Nyokiyasu/RemoteHand-controller/Solid/コントローラ(ジョイスティック).SLDASM

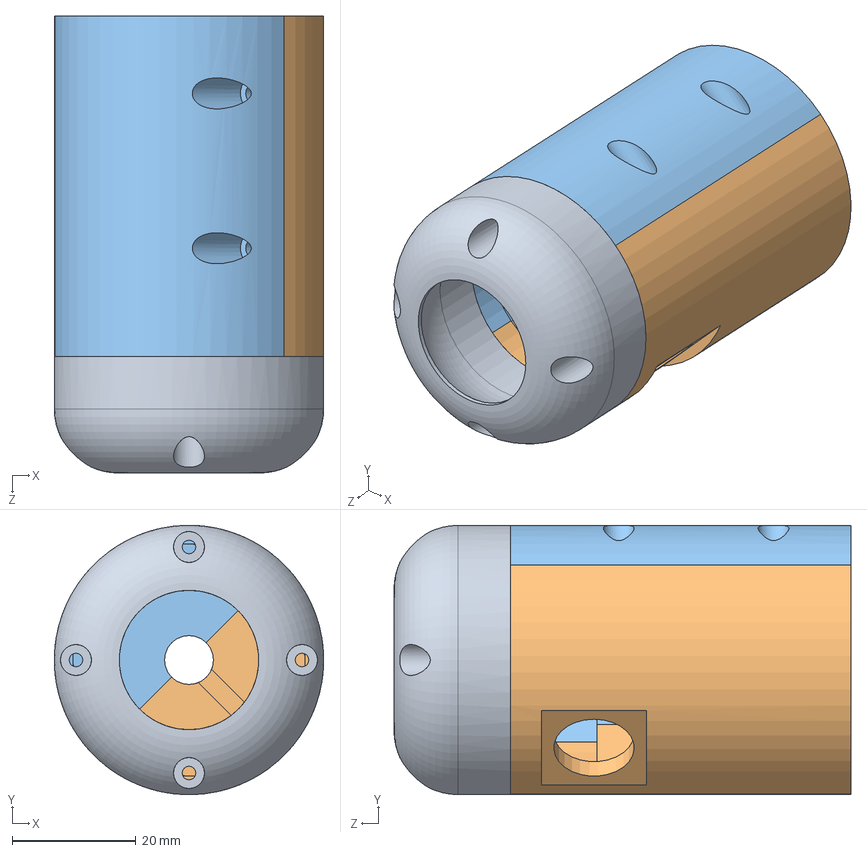
[picture p1: CAD file, 2017-09-04]
Solid/コントローラ(ジョイスティック).SLDASM
43.5 x 43.5 x 73.8 mm
ジョイスティックのカバー
ジョイスティック持つところ_halfbody
ジョイスティック持つところ_halfhead
