Nyokiyasu/RemoteHand-controller/Solid/ジョイスティック持つところ_halfbody.SLDPRT

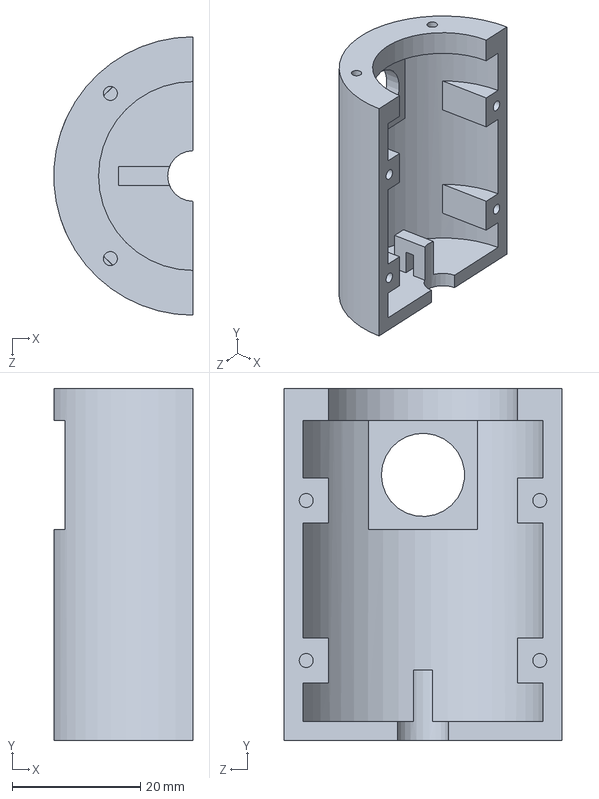
[picture p2: CAD file, 2017-09-04]
Solid/ジョイスティック持つところ_halfbody.SLDPRT
21.7 x 55.0 x 43.5 mm
