Nyokiyasu/RemoteHand-controller/Solid/ジョイスティック持つところ_halfhead.SLDPRT

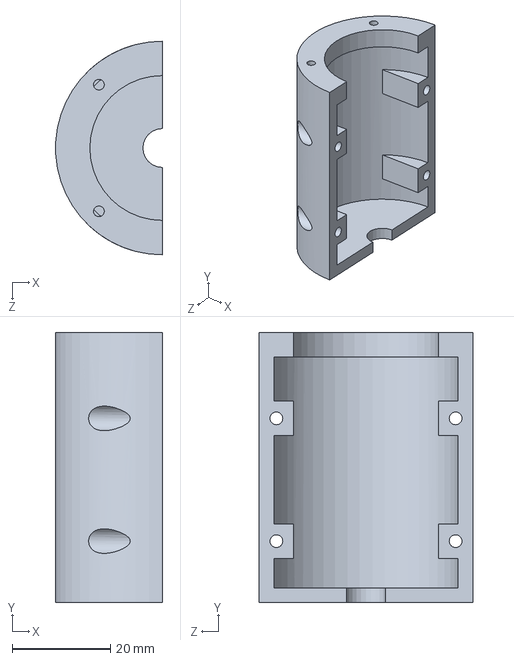
[picture p3: CAD file, 2017-09-04]
Solid/ジョイスティック持つところ_halfhead.SLDPRT
21.7 x 55.0 x 43.5 mm
