Nyokiyasu/RemoteHand-controller/Solid/ジョイスティック持つところ.SLDPRT

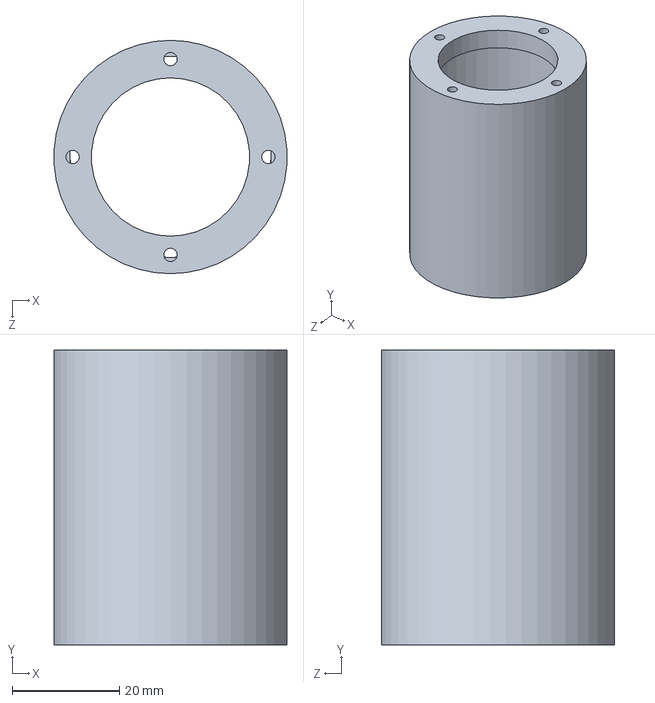
[picture p4: CAD file, 2017-08-24]
Solid/ジョイスティック持つところ.SLDPRT
43.4 x 55.0 x 43.5 mm
