Nyokiyasu/RemoteHand-controller/Solid/ジョイスティックのカバー.SLDPRT

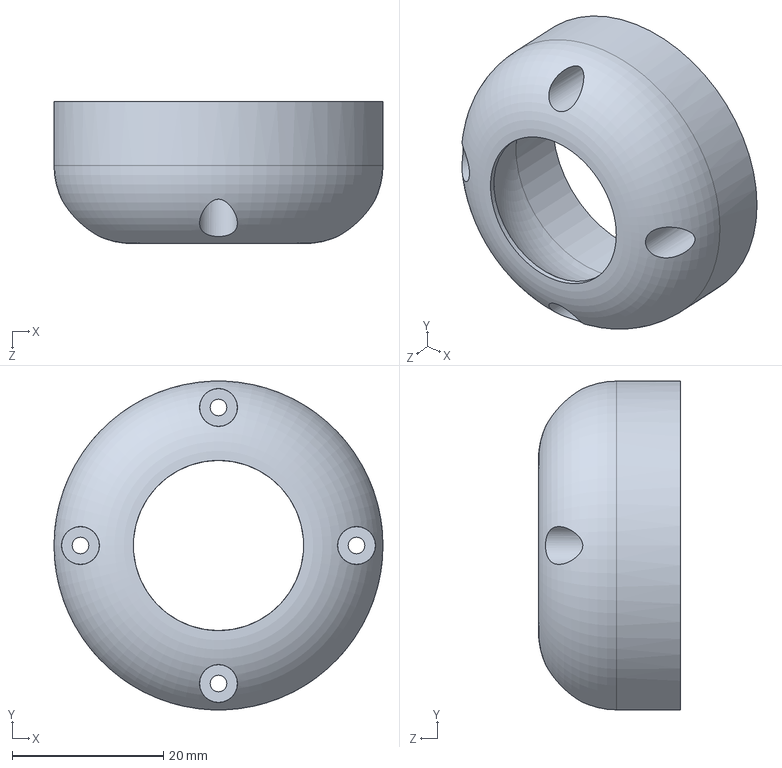
[picture p5: CAD file, 2017-08-24]
Solid/ジョイスティックのカバー.SLDPRT
43.5 x 43.5 x 18.8 mm
