Nyokiyasu/RemoteHand-controller/Solid/ジョイスティック.SLDPRT

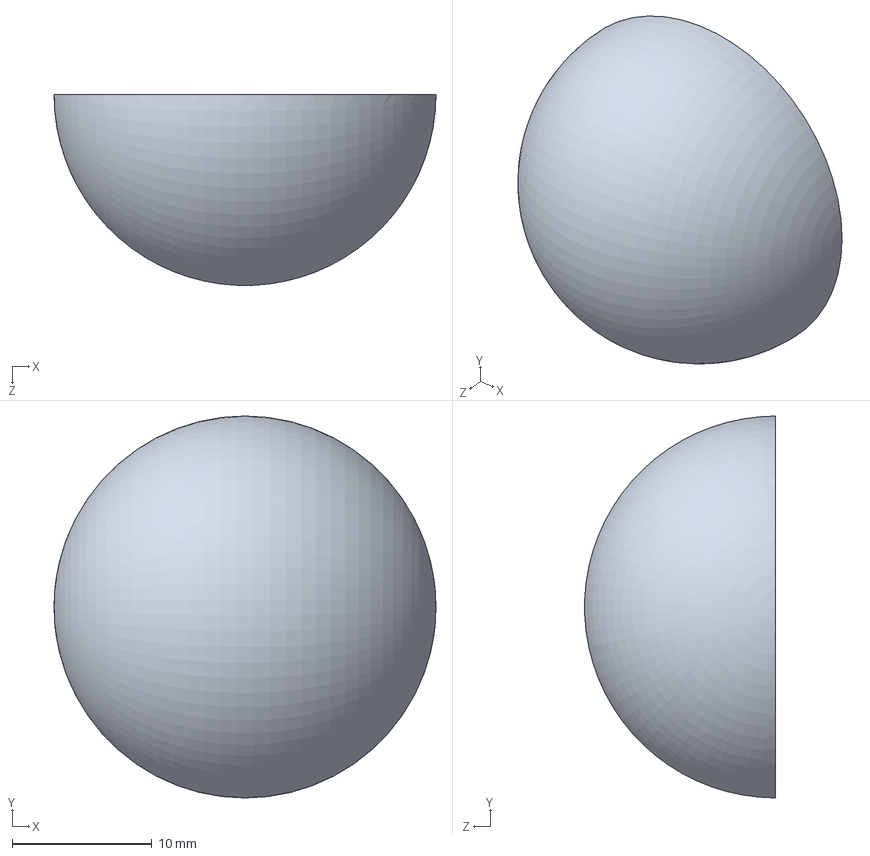
[picture p6: CAD file, 2017-08-09]
Solid/ジョイスティック.SLDPRT
27.3 x 27.3 x 13.6 mm
