Nyokiyasu/RemoteHand-controller/Solid/ジョイスティック固定SLDPRT.SLDPRT

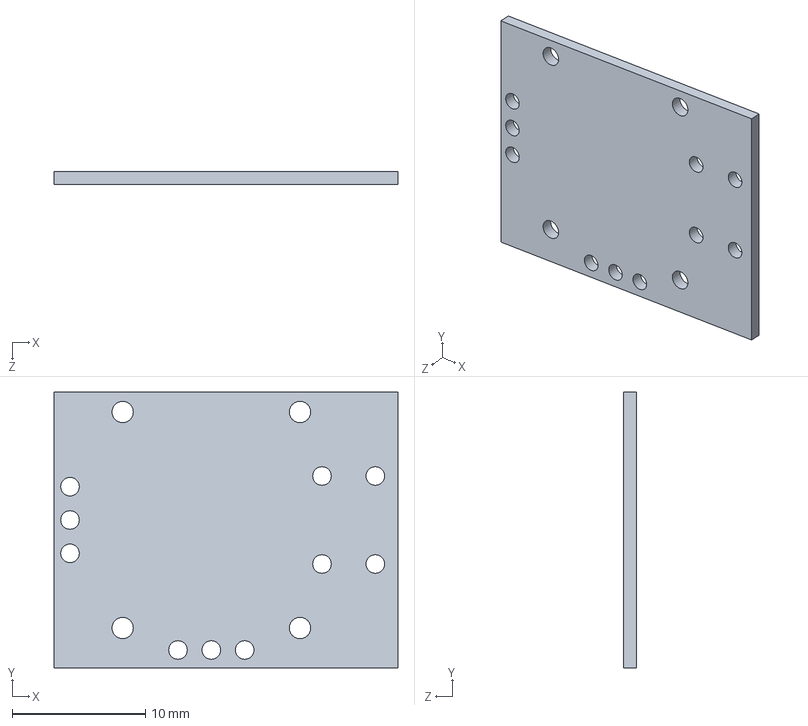
[picture p7: CAD file, 2017-08-08]
Solid/ジョイスティック固定SLDPRT.SLDPRT
25.8 x 20.7 x 1.00 mm
