Nyokiyasu/RemoteHand-controller/Circuit/MainControl/V2/rhand_controller.kicad_pcb

## KiCad design Circuit/MainControl/V2/rhand_controller.kicad_pcb (2017-09-01)

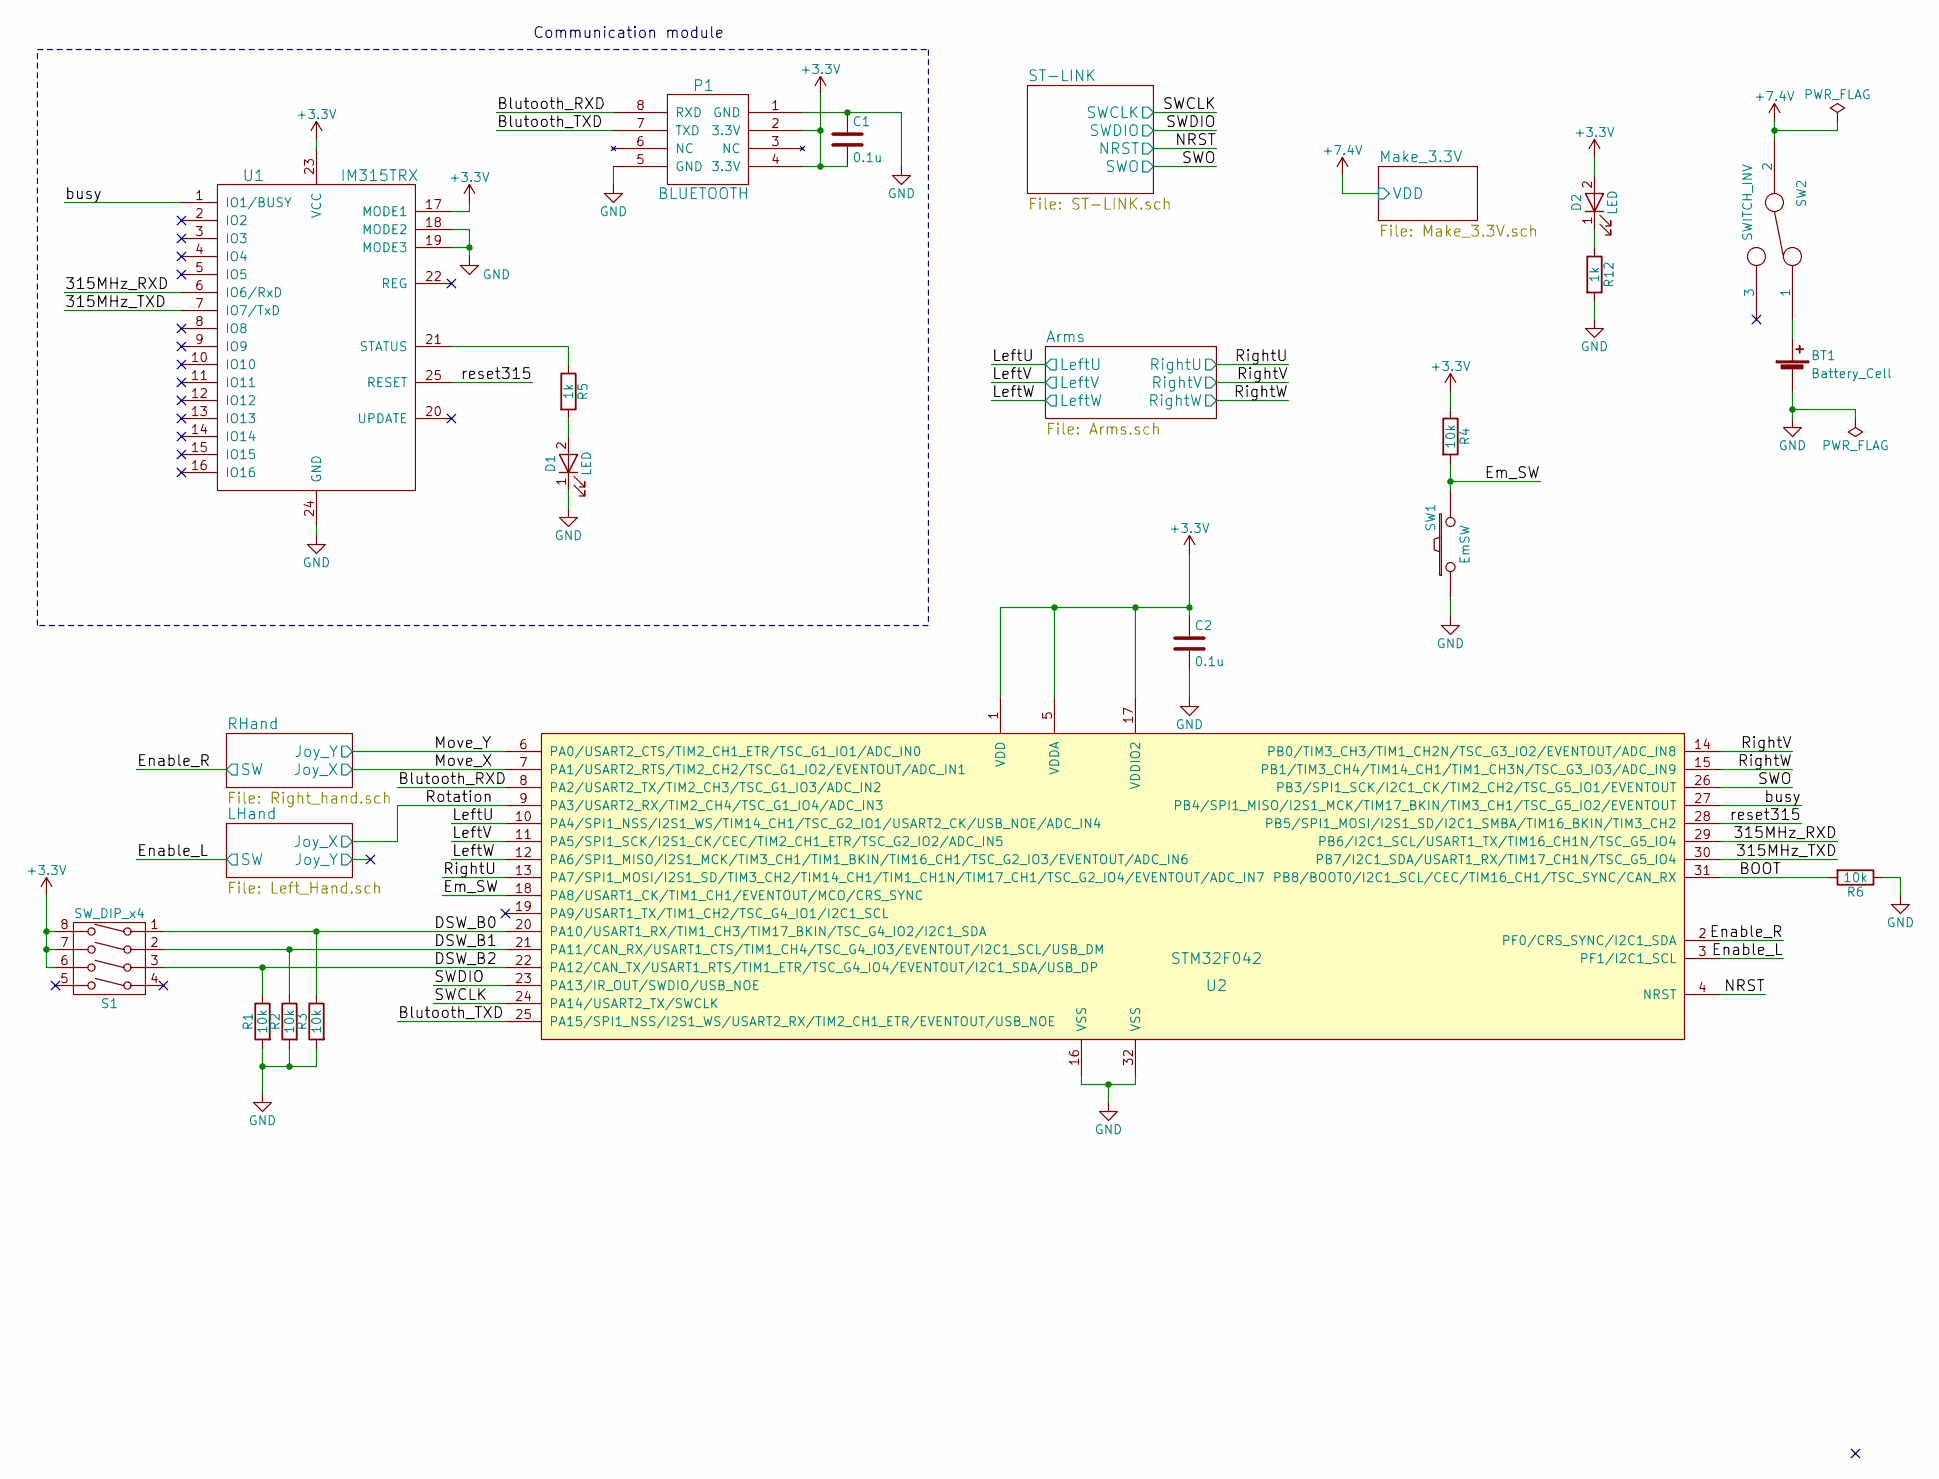
[picture p8: schematic rhand_controller.sch]

Parts:
BT1: Battery_Cell; XT_Mdot
C1, C2: 0.1u; C_0805_HandSoldering_LP
D1, D2: LED; LED_D5.0mm
P1: BLUETOOTH; ESD200
R1, R2, R3, R6: 10k; R_0603_HandSoldering_LP
R4: 10k; R_Axial_DIN0207_L6.3mm_D2.5mm_P7.62mm_Horizontal
R5, R12: 1k; R_Axial_DIN0207_L6.3mm_D2.5mm_P7.62mm_Horizontal
S1: SW_DIP_x4; SW_DIP_x4_W7.62mm_Slide
SW1: EmSW; XA_2Pin_LP
SW2: SWITCH_INV; _SW_TGR
U1: IM315TRX; IM315
U2: STM32F042; LQFP-32_7x7mm_Pitch0.8mm

Connections:
+3V3: C1.2, C2.1, D2.2 (A), P1.2 (3.3V), P1.4 (3.3V), R4.1, S1.6, S1.7, S1.8, U1.17 (MODE1), U1.23 (VCC), U2.1 (VDD), U2.5 (VDDA), U2.17 (VDDIO2); also elsewhere on the board
+7.4V: SW2.2; also elsewhere on the board
/315MHz_RXD: U1.6 (IO6/RxD), U2.29 (PB6/I2C1_SCL/USART1_TX/TIM16_CH1N/TSC_G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)
/315MHz_TXD: U1.7 (IO7/TxD), U2.30 (PB7/I2C1_SDA/USART1_RX/TIM17_CH1N/TSC_G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)
/BOOT: R6.2, U2.31 (PB8/BOOT0/I2C1_SCL/CEC/TIM16_CH1/TSC_SY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)
/Blutooth_RXD: P1.8 (RXD), U2.8 (PA2/USART2_TX/TIM2_CH3/TSC_G1_IO3/ADC_I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)
/Blutooth_TXD: P1.7 (TXD), U2.25 (PA15/SPI1_NSS/I2S1_WS/USART2_RX/TIM2_CH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)
/DSW_B0: R3.1, S1.1, U2.20 (PA10/USART1_RX/TIM1_CH3/TIM17_BKIN/TSC_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)
/DSW_B1: R2.1, S1.2, U2.21 (PA11/CAN_RX/USART1_CTS/TIM1_CH4/TSC_G4_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)
/DSW_B2: R1.1, S1.3, U2.22 (PA12/CAN_TX/USART1_RTS/TIM1_ETR/TSC_G4_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)
/Em_SW: R4.2, SW1.2, U2.18 (PA8/USART1_CK/TIM1_CH1/EVENTOUT/MCO/CRS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)
/Enable_L: U2.3 (PF1/I2C1_SCL); also elsewhere on the board
/Enable_R: U2.2 (PF0/CRS_SYNC/I2C1_SDA); also elsewhere on the board
/LeftU: U2.10 (PA4/SPI1_NSS/I2S1_WS/TIM14_CH1/TSC_G2_I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); also elsewhere on the board
/LeftV: U2.11 (PA5/SPI1_SCK/I2S1_CK/CEC/TIM2_CH1_ETR/T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); also elsewhere on the board
/LeftW: U2.12 (PA6/SPI1_MISO/I2S1_MCK/TIM3_CH1/TIM1_BK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); also elsewhere on the board
/Move_X: U2.7 (PA1/USART2_RTS/TIM2_CH2/TSC_G1_IO2/EVEN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); also elsewhere on the board
/Move_Y: U2.6 (PA0/USART2_CTS/TIM2_CH1_ETR/TSC_G1_IO1/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); also elsewhere on the board
/NRST: U2.4 (NRST); also elsewhere on the board
/RightU: U2.13 (PA7/SPI1_MOSI/I2S1_SD/TIM3_CH2/TIM14_CH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); also elsewhere on the board
/RightV: U2.14 (PB0/TIM3_CH3/TIM1_CH2N/TSC_G3_IO2/EVENT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); also elsewhere on the board
/RightW: U2.15 (PB1/TIM3_CH4/TIM14_CH1/TIM1_CH3N/TSC_G3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); also elsewhere on the board
/Rotation: U2.9 (PA3/USART2_RX/TIM2_CH4/TSC_G1_IO4/ADC_I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); also elsewhere on the board
/SWCLK: U2.24 (PA14/USART2_TX/SWCLK); also elsewhere on the board
/SWDIO: U2.23 (PA13/IR_OUT/SWDIO/USB_NOE); also elsewhere on the board
/SWO: U2.26 (PB3/SPI1_SCK/I2C1_CK/TIM2_CH2/TSC_G5_IO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); also elsewhere on the board
/busy: U1.1 (IO1/BUSY), U2.27 (PB4/SPI1_MISO/I2S1_MCK/TIM17_BKIN/TIM3_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)
/reset315: U1.25 (RESET), U2.28 (PB5/SPI1_MOSI/I2S1_SD/I2C1_SMBA/TIM16_B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)
GND: BT1.2 (-), C1.1, C2.2, D1.1 (K), P1.1 (GND), P1.5 (GND), R1.2, R2.2, R3.2, R6.1, R12.2, SW1.1, U1.18 (MODE2), U1.19 (MODE3), U1.24 (GND), U2.16 (VSS), U2.32 (VSS); also elsewhere on the board
unnamed: BT1.1 (+), SW2.1
unnamed: D1.2 (A), R5.2
unnamed: D2.1 (K), R12.1
unnamed: R5.1, U1.21 (STATUS)

Notes on the sheet:
Communication module

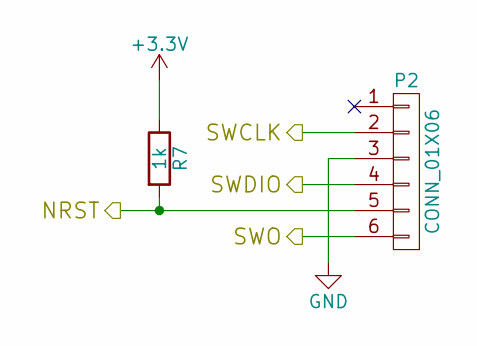
[picture p9: schematic ST-LINK.sch]

Parts:
P2: CONN_01X06; Pin_Header_Straight_1x06_Pitch2.54mm
R7: 1k; R_Axial_DIN0207_L6.3mm_D2.5mm_P7.62mm_Horizontal

Connections:
+3V3: R7.1; also elsewhere on the board
/NRST: P2.5, R7.2; also elsewhere on the board
/SWCLK: P2.2; also elsewhere on the board
/SWDIO: P2.4; also elsewhere on the board
/SWO: P2.6; also elsewhere on the board
GND: P2.3; also elsewhere on the board

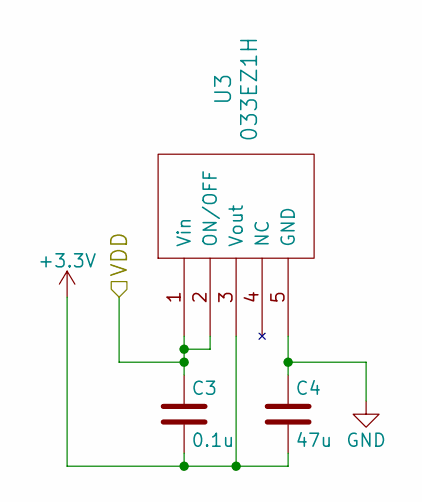
[picture p10: schematic Make_3.3V.sch]

Parts:
C3: 0.1u; C_0805_HandSoldering_LP
C4: 47u; C_1210_HandSoldering_LP
U3: 033EZ1H; PQ033EZ1HZ

Connections:
+3V3: C3.2, C4.2, U3.3 (Vout); also elsewhere on the board
+7.4V: C3.1, U3.1 (Vin), U3.2 (ON/OFF); also elsewhere on the board
GND: C4.1, U3.5 (GND); also elsewhere on the board

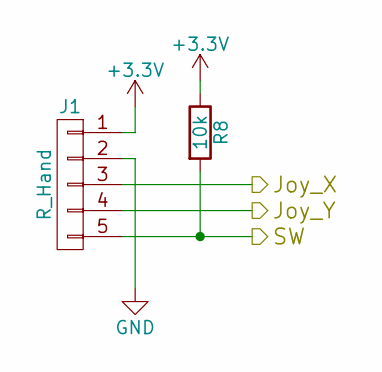
[picture p11: schematic Right_hand.sch]

Parts:
J1: R_Hand; XA_5Pin_LP
R8: 10k; R_Axial_DIN0207_L6.3mm_D2.5mm_P7.62mm_Horizontal

Connections:
+3V3: J1.1, R8.1; also elsewhere on the board
/Enable_R: J1.5, R8.2; also elsewhere on the board
/Move_X: J1.3; also elsewhere on the board
/Move_Y: J1.4; also elsewhere on the board
GND: J1.2; also elsewhere on the board

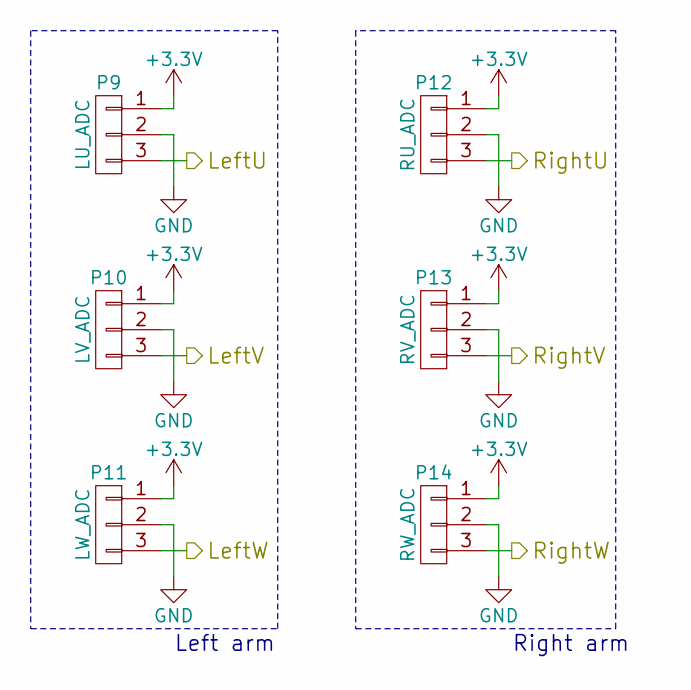
[picture p12: schematic Arms.sch]

Parts:
P9: LU_ADC; XA_3Pin_LP
P10: LV_ADC; XA_3Pin_LP
P11: LW_ADC; XA_3Pin_LP
P12: RU_ADC; XA_3Pin_LP
P13: RV_ADC; XA_3Pin_LP
P14: RW_ADC; XA_3Pin_LP

Connections:
+3V3: P9.1, P10.1, P11.1, P12.1, P13.1, P14.1; also elsewhere on the board
/LeftU: P9.3; also elsewhere on the board
/LeftV: P10.3; also elsewhere on the board
/LeftW: P11.3; also elsewhere on the board
/RightU: P12.3; also elsewhere on the board
/RightV: P13.3; also elsewhere on the board
/RightW: P14.3; also elsewhere on the board
GND: P9.2, P10.2, P11.2, P12.2, P13.2, P14.2; also elsewhere on the board

Notes on the sheet:
Right arm
Left arm

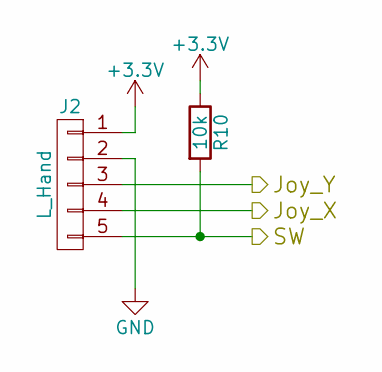
[picture p13: schematic Left_Hand.sch]

Parts:
J2: L_Hand; XA_5Pin_LP
R10: 10k; R_Axial_DIN0207_L6.3mm_D2.5mm_P7.62mm_Horizontal

Connections:
+3V3: J2.1, R10.1; also elsewhere on the board
/Enable_L: J2.5, R10.2; also elsewhere on the board
/LHand/Joy_Y: J2.3
/Rotation: J2.4; also elsewhere on the board
GND: J2.2; also elsewhere on the board

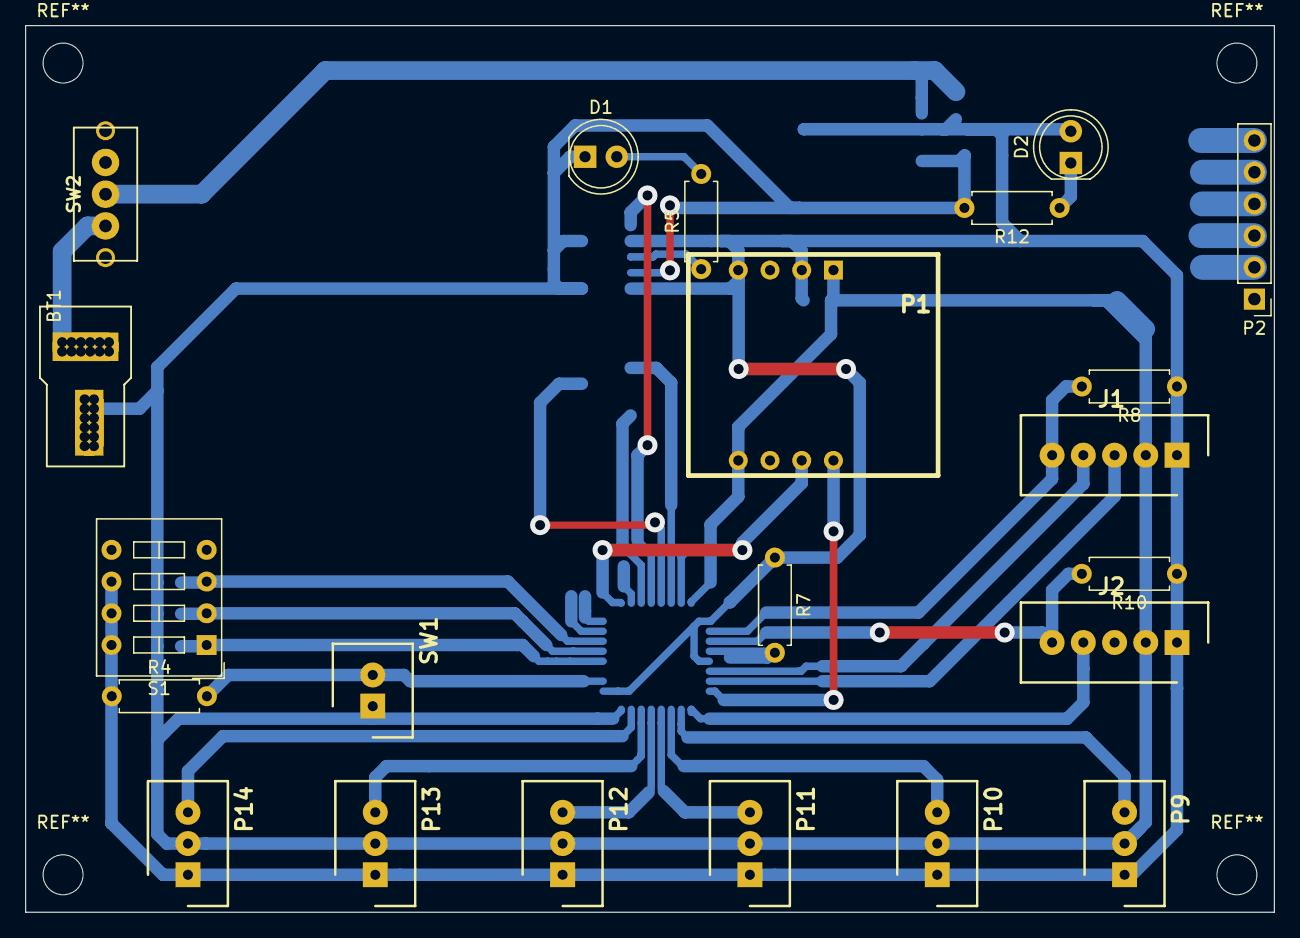
[picture p14: board rhand_controller.kicad_pcb from above]

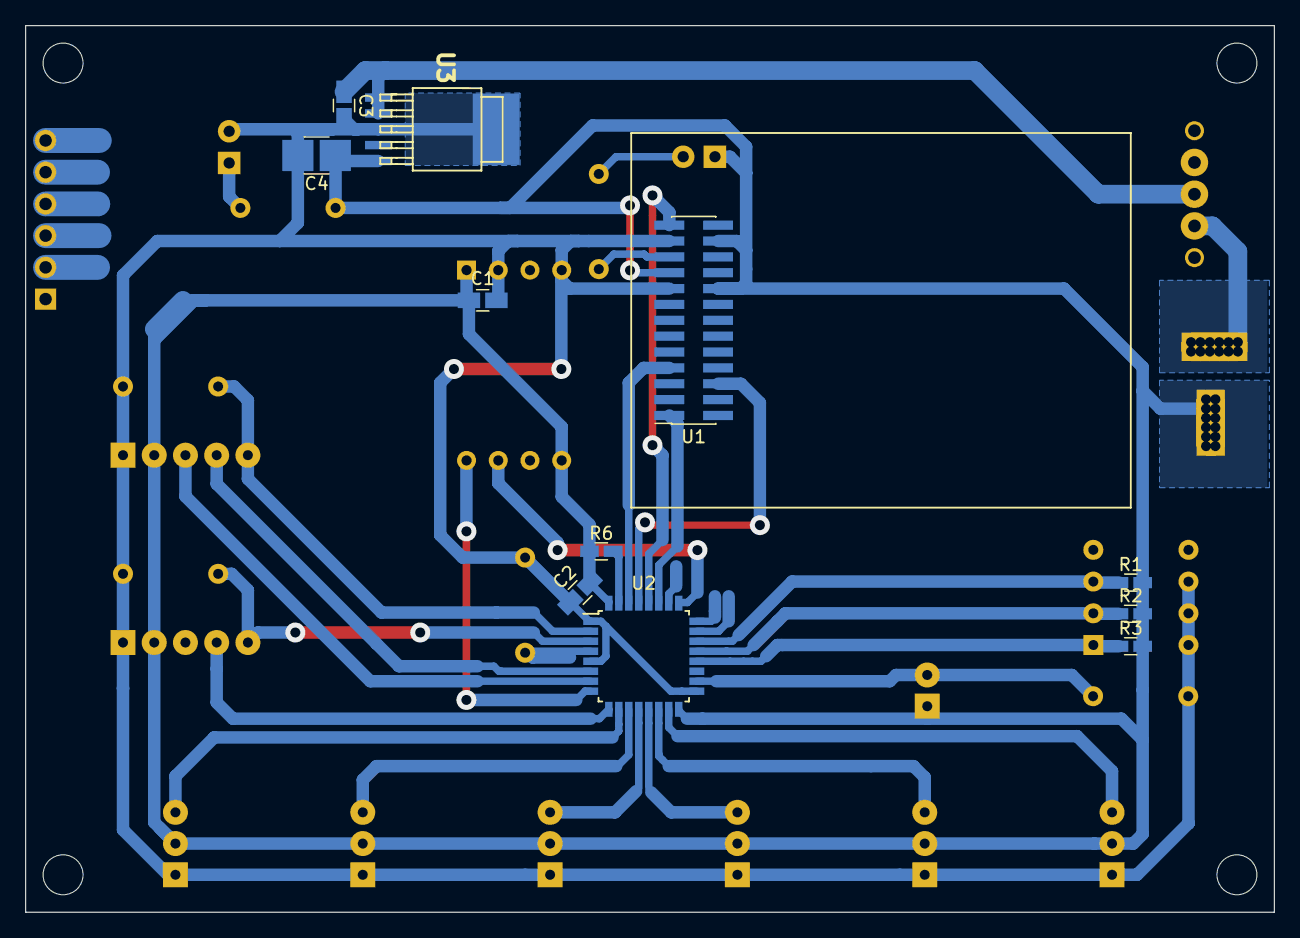
[picture p15: board rhand_controller.kicad_pcb from below]

Board: 2 copper layers, 100.0 x 71.0 mm, 33 parts (11 on the bottom side), 33 nets.
