Nyokiyasu/RemoteHand-controller/program/src/RemoteHand.c

/**
  ******************************************************************************
  * @file    main.c
  * @author  Ac6
  * @version V1.0
  * @date    01-December-2013
  * @brief   Default main function.
  ******************************************************************************
*/


#include <RemoteHand.h>

/*グローバル変数 ==================================================== */
static ringBuffer_t Bluetooth_buffer, IM315TRX_buffer;

// システムタイマ，1msごとに1ずつ増加する．
int gSystemTimer_ms = 0;

// delay関数のためのカウント値
static int timingDelay_ms;

//ADCの変換結果がDMAによって代入される
//JoyX,Y,LeftU,V,W,RightU,V,Wの順番に格納されている
uint8_t ADC_value[8];


RHC_t studio;


int main(void)
{
	/*変数定義*/
	uint8_t mode;
	RHC_t data;
	int i=0;

	/*メインクロックを8MHzから48MHzへ変更*/
	RCC_PLLConfig(RCC_PLLSource_HSI_Div2,RCC_PLLMul_12);
	RCC_PLLCmd(ENABLE);
	RCC_SYSCLKConfig(RCC_SYSCLKSource_PLLCLK);

	/*初期化関数群*/
	DipSW_init();
	Switches_init();
	ADCPort_init();
	SysTick_Config(48000);	//systickTimerを1msに設定
	IM315TRX_USART_init();
	Bluetooth_USART_init();

	mode = DipSW_read();

	switch(mode){
	case 0:
		Bluetooth_Module_init(CONNECTCOMMAND0);
		break;
	case 1:
		Bluetooth_Module_init(CONNECTCOMMAND1);
		break;
	case 2:
		Bluetooth_Module_init(CONNECTCOMMAND2);
		break;
	case 3:
		Bluetooth_Module_init(CONNECTCOMMAND3);
		break;
	case 4:
		Bluetooth_Module_init(CONNECTCOMMAND4);
		break;
	case 5:
		Bluetooth_Module_init(CONNECTCOMMAND5);
		break;
	case 6:
		Bluetooth_Module_init(CONNECTCOMMAND6);
		break;
	case 7:
		break;
		}

	while(1)
	{
		if(!Check_Enable())
		{
			GetSensorData(&data);
			Conv4Bit2Ascii(&data);
		}
#ifdef PC_Debug
		for (i=0;i<16;i++)
		{
			Bluetooth_SendByte(data.SendData[i]);
			if(i%2)Bluetooth_SendByte(',');
		}
		Bluetooth_SendString("\r\n");
#endif
		studio = data;
		Bluetooth_SendRHCFrame(&data);
		IM315TRX_SendRHCFrame(&data);
	}

}

/* -------------------------------------------------
 * @関数名	:	Bluetooth_init,IM315TRX_init
 * @概要	:	Bluetooth,IM315TRXのUSARTを初期化する
 * @引数	:	なし
 * @戻り値	:	なし
 * ---------------------------------------------- */
void Bluetooth_USART_init(void)
{
	GPIO_InitTypeDef	GPIO_InitStructure;
	USART_InitTypeDef	USART_InitStructure;
	NVIC_InitTypeDef	NVIC_InitStructure;

	/*USART2*/
	RCC_APB1PeriphClockCmd(RCC_APB1Periph_USART2, ENABLE);
	RCC_AHBPeriphClockCmd(RCC_AHBPeriph_GPIOA, ENABLE);

	GPIO_StructInit(&GPIO_InitStructure);
	GPIO_InitStructure.GPIO_Pin = GPIO_Pin_2|GPIO_Pin_3;
	GPIO_InitStructure.GPIO_Mode = GPIO_Mode_AF;
	GPIO_Init(GPIOA,&GPIO_InitStructure);
	GPIO_PinAFConfig(GPIOA,GPIO_PinSource2,GPIO_AF_1);
	GPIO_PinAFConfig(GPIOA,GPIO_PinSource3,GPIO_AF_1);

	USART_StructInit(&USART_InitStructure);
	USART_Init(USART2,&USART_InitStructure);

	NVIC_InitStructure.NVIC_IRQChannel = USART2_IRQn;
	NVIC_InitStructure.NVIC_IRQChannelPriority = 0;
	NVIC_InitStructure.NVIC_IRQChannelCmd = ENABLE;
	NVIC_Init(&NVIC_InitStructure);

	USART_ITConfig(USART2,USART_IT_RXNE,ENABLE);
	USART_Cmd(USART2,ENABLE);

	return;
}
void IM315TRX_USART_init(void)
{
	GPIO_InitTypeDef	GPIO_InitStructure;
	USART_InitTypeDef	USART_InitStructure;
	NVIC_InitTypeDef	NVIC_InitStructure;

	RCC_APB2PeriphClockCmd(RCC_APB2Periph_USART1, ENABLE);
	RCC_AHBPeriphClockCmd(RCC_AHBPeriph_GPIOB, ENABLE);

	/*busy*/
	GPIO_StructInit(&GPIO_InitStructure);
	GPIO_InitStructure.GPIO_Pin = GPIO_Pin_4;
	GPIO_InitStructure.GPIO_Mode = GPIO_Mode_IN;
	GPIO_Init(GPIOB,&GPIO_InitStructure);

	/*USART1*/
	GPIO_StructInit(&GPIO_InitStructure);
	GPIO_InitStructure.GPIO_Pin = GPIO_Pin_6|GPIO_Pin_7;
	GPIO_InitStructure.GPIO_Mode = GPIO_Mode_AF;
	GPIO_Init(GPIOB,&GPIO_InitStructure);
	GPIO_PinAFConfig(GPIOB,GPIO_PinSource6,GPIO_AF_0);
	GPIO_PinAFConfig(GPIOB,GPIO_PinSource7,GPIO_AF_0);

	USART_StructInit(&USART_InitStructure);
	USART_InitStructure.USART_BaudRate = 19200;
	USART_Init(USART1,&USART_InitStructure);

	NVIC_InitStructure.NVIC_IRQChannel = USART1_IRQn;
	NVIC_InitStructure.NVIC_IRQChannelPriority = 0;
	NVIC_InitStructure.NVIC_IRQChannelCmd = ENABLE;
	NVIC_Init(&NVIC_InitStructure);

	USART_ITConfig(USART1,USART_IT_RXNE,ENABLE);
	USART_Cmd(USART1,ENABLE);

	return;
}

/* -------------------------------------------------
 * @関数名			:	Bluetooth_init,IM315TRX_init
 * @概要			:	Bluetooth,IM315TRXのUSARTを初期化する
 * @引数-command	:	通信相手の設定コマンド
 * @戻り値			:	なし
 * ---------------------------------------------- */
void Bluetooth_Module_init(char *command)
{
	char buff[128] = {0};

	Bluetooth_RecvString(buff,128); //"OK"を受けたはず
	while (!CoincidenceCheck(buff,"OK",2))
	{
		Bluetooth_RecvString(buff,128);
	}
	if (command)
	{
		Bluetooth_SendString(command);
		Bluetooth_SendString("\r\n");
	}
	Bluetooth_RecvString(buff,128);
	while (!CoincidenceCheck(buff,"OK",2))
	{
		Bluetooth_RecvString(buff,128);
	}
	Bluetooth_RecvString(buff,128);
	while (!CoincidenceCheck(buff,"CONNECT",7))
	{
		Bluetooth_RecvString(buff,128);
	}
	return;
}

/* -------------------------------------------------
 * @関数名		:	Bluetooth_RecvByte, IM315TRX_RecvByte
 * @概要		:	Bluetooth, IM315TRXから1[Byte]の情報を受け取る
 * @引数		:	なし
 * @戻り値		:	受信したデータ
 * ---------------------------------------------- */
int Bluetooth_RecvByte(void)
{
	int data;
	int time0;

	time0 = SystemTimer_ms_Check();
	while(Bluetooth_buffer.recvPtr_in == Bluetooth_buffer.recvPtr_out)
	{
		if((SystemTimer_ms_Check()-time0) > BLUETOOTH_RECV_TIMEOUT_MS)	return -1;
	}

	data = Bluetooth_buffer.buff[Bluetooth_buffer.recvPtr_out];

	if(++Bluetooth_buffer.recvPtr_out == RECV_RINGBUFF_SIZE)
	{
		Bluetooth_buffer.recvPtr_out = 0;
	}
	return data;
}
int	IM315TRX_RecvByte(void)
{
	int data;
	int time0;

	time0 = SystemTimer_ms_Check();
	while(IM315TRX_buffer.recvPtr_in == IM315TRX_buffer.recvPtr_out)
	{
		if((SystemTimer_ms_Check()-time0) > IM315TRX_RECV_TIMEOUT_MS)	return -1;
	}

	data = IM315TRX_buffer.buff[IM315TRX_buffer.recvPtr_out];

	if(++IM315TRX_buffer.recvPtr_out == RECV_RINGBUFF_SIZE)
	{
		IM315TRX_buffer.recvPtr_out = 0;
	}
	return data;
}

/* -------------------------------------------------
 * @関数名		:	Bluetooth_RecvString, IM315TRX_RecvString
 * @概要		:	Bluetooth, IM315TRXからmax[Byte]受け取り、
 * 					文字列として解釈する
 * @引数-buf	:	受け取った文字列の格納先
 *      -max	:	文字列の長さ[Byte]
 * @戻り値		:	エラー
 * ---------------------------------------------- */
int	Bluetooth_RecvString(char *buf, int max)
{
	int i;
	for(i = 0; i < max-i; i++)
	{
		*buf = Bluetooth_RecvByte();

		if((signed char)*buf == -1)	return -1;
		if(*buf == '\r')
		{
			*buf = 0;
			return i+1;
		}
		if(*buf == 0x08)
		{
			buf -= 2;
			i -= 2;
		}
		if(*buf != '\n')	buf++;
		else				i--;
	}
	*buf = 0;
	return i+1;
}
int IM315TRX_RecvString (char *buf, int max)
{
	int i;
	for(i = 0; i < max-i; i++)
	{
		*buf = IM315TRX_RecvByte();

		if(*buf == -1)	return -1;
		if(*buf == '\r')
		{
			*buf = 0;
			return i+1;
		}
		if(*buf == 0x08)
		{
			buf -= 2;
			i -= 2;
		}
		if(*buf != '\n')	buf++;
		else				i--;
	}
	*buf = 0;
	return i+1;
}

/* -------------------------------------------------
 * @関数名		:	Bluetooth_SendByte, IM315TRX_SendByte
 * @概要		:	Bluetooth, IM315TRXから1[Byte]送信する
 * @引数-byte	:	送信する1[Byte]文字
 * @戻り値		:	なし
 * ---------------------------------------------- */
void Bluetooth_SendByte(uint8_t byte)
{
	while (USART_GetFlagStatus(USART2, USART_FLAG_TC) == RESET);
	USART_SendData(USART2, byte);
}
void IM315TRX_SendByte(uint8_t byte)
{
	while (USART_GetFlagStatus(USART1, USART_FLAG_TC) == RESET);
	USART_SendData(USART1, byte);
}

/* -------------------------------------------------
 * @関数名		:	Bluetooth_SendString, IM315TRX_SendString
 * @概要		:	Bluetooth, IM315TRXから文字列を送信する
 * @引数-buf	:	送信する文字列
 * @戻り値		:	なし
 * ---------------------------------------------- */
void Bluetooth_SendString(char *str)
{
	while(*str)
	{
		Bluetooth_SendByte(*str++);
	}
}
void IM315TRX_SendString(char *str)
{
	while(*str)
	{
		IM315TRX_SendByte(*str++);
	}
}

/* -------------------------------------------------
 * @関数名		:	Bluetooth_SendRHCFrame,IM315TRX_SendRHCFlame
 * @概要		:	Bluetooth,IM315でRHCのデータフレームを送信する
 * @引数-byte	:	送信するデータ(8[byte])
 * ---------------------------------------------- */
void Bluetooth_SendRHCFrame(RHC_t *data)
{
	uint8_t i;
	for (i=0;i<8;i++)	Bluetooth_SendByte(data->SensorData.Bytes[i]);
}
int IM315TRX_SendRHCFrame(RHC_t *data)
{
	uint16_t i;
	char check[8];
	int time0;

	time0 = SystemTimer_ms_Check();
	while(Check_Busy())
	{
		if((SystemTimer_ms_Check()-time0) > IM315TRX_SEND_TIMEOUT_MS)	return -1;
	}

	IM315TRX_SendString("TXDT ");
	for (i=0;i<16;i++)	IM315TRX_SendByte(data->SendData[i]);
	IM315TRX_SendString("\r\n");

//	IM315TRX_RecvString(check,8);
//	if(CoincidenceCheck(check,"OK",2))	return 0;
//	else	return -1;
	return 0;
}

/* -------------------------------------------------
 * @関数名		:	CoincidenceCheck
 * @概要		:	numで指定した長さの2つの文字列を比較する
 * @引数-str1	:	比較する文字列1
 * @引数-str2	:	比較する文字列2
 * @引数-num	:	文字列の長さ
 * @戻り値		:	成功or失敗
 * ---------------------------------------------- */
uint16_t CoincidenceCheck(char *str1,char *str2,uint16_t num)
{
	uint16_t coincidence=1;
	uint16_t i;
	for (i=0;i<num;i++) {
		if (*str1++!=*str2++) {
			coincidence=0;
			break;
		}
	}
	return coincidence;
}

/* -------------------------------------------------
 * @関数名		:	DipSW_init
 * @概要		:	DipSWに使うGPIOの初期化
 * @戻り値		:	なし
 * ---------------------------------------------- */
void DipSW_init(void)
{
	GPIO_InitTypeDef init_gpio;

	RCC_AHBPeriphClockCmd(RCC_AHBPeriph_GPIOA, ENABLE);

	/*DipSW*/
	GPIO_StructInit(&init_gpio);
	init_gpio.GPIO_Pin = GPIO_Pin_10|GPIO_Pin_11|GPIO_Pin_12;	//
	init_gpio.GPIO_Mode = GPIO_Mode_IN;
	GPIO_Init(GPIOA,&init_gpio);

	return;
}

/* -------------------------------------------------
 * @関数名		:	DipSW_read
 * @概要		:	DipSWの読出し
 * @戻り値		:	なし
 * ---------------------------------------------- */
uint8_t DipSW_read(void)
{
	uint8_t data=0;
	data = data|GPIO_ReadInputDataBit(GPIOA,GPIO_Pin_10) << 0;
	data = data|GPIO_ReadInputDataBit(GPIOA,GPIO_Pin_11) << 1;
	data = data|GPIO_ReadInputDataBit(GPIOA,GPIO_Pin_12) << 2;
	return data;
}

/* -------------------------------------------------
 * @関数名		:	Switches_init
 * @概要		:	手元のスイッチの初期化
 * @戻り値		:	なし
 * ---------------------------------------------- */
void Switches_init(void)
{
	GPIO_InitTypeDef init_gpio;

	RCC_AHBPeriphClockCmd(RCC_AHBPeriph_GPIOA, ENABLE);
	RCC_AHBPeriphClockCmd(RCC_AHBPeriph_GPIOF, ENABLE);

	/*CW&CCW&EmSW*/
	GPIO_StructInit(&init_gpio);
	init_gpio.GPIO_Pin = GPIO_Pin_8|GPIO_Pin_9|GPIO_Pin_15;	//
	init_gpio.GPIO_Mode = GPIO_Mode_IN;
	GPIO_Init(GPIOA,&init_gpio);
	/*Enable&Wall*/
	GPIO_StructInit(&init_gpio);
	init_gpio.GPIO_Pin = GPIO_Pin_0|GPIO_Pin_1;	//
	init_gpio.GPIO_Mode = GPIO_Mode_IN;
	GPIO_Init(GPIOF,&init_gpio);

	return;
}

/* -------------------------------------------------
 * @関数名		:	ADC_init
 * @概要		:	アナログセンサポートの初期化
 * 				 	DMAを用いて連続モードで起動
 * @戻り値		:	なし
 * ---------------------------------------------- */
void ADCPort_init(void)
{
	GPIO_InitTypeDef	GPIO_InitStructure;
	ADC_InitTypeDef		ADC_InitStructure;
	DMA_InitTypeDef		DMA_InitStructure;

	RCC_AHBPeriphClockCmd(RCC_AHBPeriph_GPIOA, ENABLE);
	RCC_AHBPeriphClockCmd(RCC_AHBPeriph_GPIOB, ENABLE);
	RCC_APB2PeriphClockCmd(RCC_APB2Periph_ADC1, ENABLE);
	RCC_AHBPeriphClockCmd(RCC_AHBPeriph_DMA1, ENABLE);

	/*GPIOの初期化*/
	GPIO_StructInit(&GPIO_InitStructure);
	GPIO_InitStructure.GPIO_Pin = GPIO_Pin_0|GPIO_Pin_1|GPIO_Pin_4|GPIO_Pin_5|GPIO_Pin_6|GPIO_Pin_7;	//
	GPIO_InitStructure.GPIO_Mode = GPIO_Mode_AN;
	GPIO_Init(GPIOA,&GPIO_InitStructure);
	GPIO_InitStructure.GPIO_Pin = GPIO_Pin_0|GPIO_Pin_1;
	GPIO_Init(GPIOB,&GPIO_InitStructure);

	/*DMAの初期化*/
	//SyscinfigでDMAの再配置をしなければいけない
	SYSCFG_DMAChannelRemapConfig(SYSCFG_DMARemap_ADC1,ENABLE);
	DMA_DeInit(DMA1_Channel1);
	DMA_StructInit(&DMA_InitStructure);
	DMA_InitStructure.DMA_PeripheralBaseAddr = (uint32_t)&ADC1->DR;
	DMA_InitStructure.DMA_MemoryBaseAddr = (uint32_t)&ADC_value[0];
	DMA_InitStructure.DMA_DIR = DMA_DIR_PeripheralSRC;
	DMA_InitStructure.DMA_BufferSize = 8;
	DMA_InitStructure.DMA_MemoryInc =  DMA_MemoryInc_Enable;
	DMA_InitStructure.DMA_Mode = DMA_Mode_Circular;
	DMA_InitStructure.DMA_Priority = DMA_Priority_VeryHigh;
	DMA_Init(DMA1_Channel1,&DMA_InitStructure);
	DMA_SetCurrDataCounter(DMA1_Channel1,8);
	DMA_Cmd(DMA1_Channel1,ENABLE);

	/*ADCの初期化*/
	ADC_StructInit(&ADC_InitStructure);
	ADC_InitStructure.ADC_Resolution = ADC_Resolution_8b;
	ADC_InitStructure.ADC_ContinuousConvMode = ENABLE;
	ADC_Init(ADC1,&ADC_InitStructure);
//	ADC_ContinuousModeCmd(ADC1,ENABLE);

	ADC_ChannelConfig(ADC1, ADC_Channel_0 , ADC_SampleTime_41_5Cycles);
	ADC_ChannelConfig(ADC1, ADC_Channel_1 , ADC_SampleTime_41_5Cycles);
	ADC_ChannelConfig(ADC1, ADC_Channel_4 , ADC_SampleTime_41_5Cycles);
	ADC_ChannelConfig(ADC1, ADC_Channel_5 , ADC_SampleTime_41_5Cycles);
	ADC_ChannelConfig(ADC1, ADC_Channel_6 , ADC_SampleTime_41_5Cycles);
	ADC_ChannelConfig(ADC1, ADC_Channel_7 , ADC_SampleTime_41_5Cycles);
	ADC_ChannelConfig(ADC1, ADC_Channel_8 , ADC_SampleTime_41_5Cycles);
	ADC_ChannelConfig(ADC1, ADC_Channel_9 , ADC_SampleTime_41_5Cycles);

	ADC_DMARequestModeConfig(ADC1,ADC_DMAMode_Circular);
	ADC_DMACmd(ADC1,ENABLE);
	ADC_Cmd(ADC1,ENABLE);

	ADC_StartOfConversion(ADC1);
}

void GetSensorData(RHC_t *data)
{
	data->SensorData.Sepalate.Right_Shoulder= ADC_value[R_SHOULDER_NUM];
	data->SensorData.Sepalate.Right_Elbow	= ADC_value[R_ELBOW_NUM];
	data->SensorData.Sepalate.Right_wrist	= ADC_value[R_WRIST_NUM];
	data->SensorData.Sepalate.Left_Shoulder	= ADC_value[L_SHOULDER_NUM];
	data->SensorData.Sepalate.Left_Elbow	= ADC_value[L_ELBOW_NUM];
	data->SensorData.Sepalate.Left_wrist	= ADC_value[L_WRIST_NUM];
	data->SensorData.Sepalate.Joy_X			= ADC_value[JOY_X_NUM]>>4;
	data->SensorData.Sepalate.Joy_Y			= ADC_value[JOY_Y_NUM]>>4;
	data->SensorData.Sepalate.Wall			= Check_wall();
	data->SensorData.Sepalate.CCW			= Check_ccw();
	data->SensorData.Sepalate.CW			= Check_cw();
}


void Conv4Bit2Ascii(RHC_t *data)
{
	uint8_t i;

	for(i=0;i<8;i++)
	{
		data->SendData[i*2]		= FourBit2Ascii[data->SensorData.HalfBytes[i].Lower];
		data->SendData[i*2+1]	= FourBit2Ascii[data->SensorData.HalfBytes[i].Higher];
	}
}

/* -------------------------------------------------
 * @関数名	:	USART1_IRQHandler, USART2_IRQHandler
 * @概要	:	USART1, USART2の受信割り込みルーチン
 * ---------------------------------------------- */
void USART1_IRQHandler(void)
{
	// 受信終了
	if(USART_GetITStatus(USART1, USART_IT_RXNE) == SET)
	{
		IM315TRX_buffer.buff[IM315TRX_buffer.recvPtr_in] = USART_ReceiveData(USART1);
		if(++IM315TRX_buffer.recvPtr_in == RECV_RINGBUFF_SIZE)
		{
			IM315TRX_buffer.recvPtr_in = 0;
		}
	}

}
void USART2_IRQHandler(void)
{
	// 受信終了
	if(USART_GetITStatus(USART2, USART_IT_RXNE) == SET)
	{
		Bluetooth_buffer.buff[Bluetooth_buffer.recvPtr_in] = USART_ReceiveData(USART2);
		if(++Bluetooth_buffer.recvPtr_in == RECV_RINGBUFF_SIZE)
		{
			Bluetooth_buffer.recvPtr_in = 0;
		}
	}
}
/* -------------------------------------------------
 * @関数名	:	SysTick_Handler
 * @概要	:	SystickTimerの割り込みルーチン
 * 				SysTick_Configで設定した値(frq)で割り込み周期が決まる
 * 				周期はSystemClock/frq[Hz]
 * ---------------------------------------------- */
void SysTick_Handler(void)
{
	gSystemTimer_ms++;
	if(timingDelay_ms)	timingDelay_ms--;
}

/* -------------------------------------------------
 * @関数名		:	delay_ms
 * @概要		:	指定時間空ループをする．
 * 					SystemCMTを初期化せずに呼び出すと，
 * 					無限ループしてしまう．
 * @引数-msec	:	ループする時間[ms]
 * @戻り値		:	なし
 * ---------------------------------------------- */
void delay_ms(int msec)
{
	timingDelay_ms = msec;
	while(timingDelay_ms);
}
