Nyokiyasu/RemoteHand-controller/(commit log)

2017-06-06 基板作成の下地
    [Make_3.3V.sch, RotarySW.sch, ST-LINK.sch, rhand_controller.kicad_pcb, rhand_controller.sch]
2017-06-06 回路図ほぼ完成
    [Make_3.3V.sch, ST-LINK.sch, rhand_controller.sch]
2017-06-07 315MHzモジュールなどの追加
    [Make_3.3V.sch, RotarySW.sch, ST-LINK.sch, rhand_controller.sch]
2017-06-07 未配線の追加
    [rhand_controller.sch]
2017-06-07 部品の割り付け
    [Make_3.3V.sch, RotarySW.sch, ST-LINK.sch, rhand_controller.sch]
2017-06-07 ライブラリの変更
2017-06-08 機能の追加
    [Make_3.3V.sch, RotarySW.sch, ST-LINK.sch, rhand_controller.sch]
2017-06-10 何を変えたか忘れたけど更新
    [Make_3.3V.sch, ST-LINK.sch, rhand_controller.sch]
2017-06-10 シートわけ
    [Digital_input.sch, Make_3.3V.sch, ST-LINK.sch, rhand_controller.sch]
2017-06-11 シート分けと移動
    [Arms.sch, Left_Hand.sch, Make_3.3V.sch, Right_hand.sch, ST-LINK.sch, rhand_controller.sch]
2017-06-12 回路図の配置変更
    [Arms.sch, Left_Hand.sch, Make_3.3V.sch, Right_hand.sch, ST-LINK.sch, rhand_controller.sch]
2017-06-13 回路図完成
    [rhand_controller.sch]
2017-06-14 実態配線図書き始め
    [Arms.sch, Left_Hand.sch, Make_3.3V.sch, Right_hand.sch, ST-LINK.sch, rhand_controller.sch]
2017-06-15 特になし
    [Arms.sch, Left_Hand.sch, Make_3.3V.sch, Right_hand.sch, ST-LINK.sch, rhand_controller.sch]
2017-06-15 部品割り付けの完了
    [Arms.sch, Left_Hand.sch, Make_3.3V.sch, Right_hand.sch, ST-LINK.sch, rhand_controller.kicad_pcb, rhand_controller.sch]
2017-06-15 部品を基板上へ適当に配置
    [Arms.sch, Left_Hand.sch, Make_3.3V.sch, Right_hand.sch, ST-LINK.sch, rhand_controller.kicad_pcb, rhand_controller.sch]
2017-06-16 ピンヘッダを表面実装へ
    [rhand_controller.kicad_pcb, rhand_controller.sch]
2017-06-16 ADCのピン配置修正と配線引きはじめ
    [Arms.sch, Left_Hand.sch, Make_3.3V.sch, Right_hand.sch, ST-LINK.sch, rhand_controller.kicad_pcb, rhand_controller.sch]
2017-06-18 あらかた終わったぞ
    [Left_Hand.sch, rhand_controller.kicad_pcb, rhand_controller.sch]
2017-06-19 IM315の位置変更
    [rhand_controller.kicad_pcb]
2017-06-19 作業しようと思ったらほとんどできなかった
    [rhand_controller.kicad_pcb]
2017-06-20 IM315のLEDの配線変更
    [Arms.sch, Left_Hand.sch, Make_3.3V.sch, Right_hand.sch, ST-LINK.sch, rhand_controller.kicad_pcb, rhand_controller.sch]
2017-06-21 実態配線図完了
    [rhand_controller.kicad_pcb]
2017-06-21 SWDのジャンパ用配線の追加とガーバーデータの作製
    [rhand_controller.kicad_pcb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]
2017-07-01 プロジェクトの作成
    [F0_Slave.cfg]
2017-07-01 DipSWの読み取り関数を追加
    [.custom.cfg]
2017-07-01 プロトタイプ宣言とBlutoothアドレス
2017-07-01 ファイルネームの変更とヘッダファイルの作成
2017-07-01 Bluetoothのinitを追加
2017-07-01 IM315の初期化を追加
2017-07-01 文字列を送信する関数の作成
2017-07-02 USARTの文字列送信関数の作成
2017-07-05 IM315の8Byte送信関数を作成
2017-07-06 手元のSWの初期化関数を追加
2017-07-07 Bluetoothで用いるUSARTでPCと通信できた
2017-07-11 USART受信用の関数等定義
2017-07-15 Bluetoothの通信成功
2017-07-15 IM315と通信可能の時のみ送信するように変更
2017-07-15 送信完了を検知するよう変更
2017-07-15 ADCがわかんねえ
2017-07-17 IM315のデバッグ完了
2017-07-17 ADC初期化のひな型完成
2017-07-17 変更なし
2017-07-17 DMAのデバッグ待ち
2017-07-17 sysconfigにもDMAの設定あるから要注意
2017-07-20 チャンネル選択とサンプリングレートの初期化
2017-07-20 ADCの値を一つのチャンネルで取得することに成功
    [RemoteHandController Debug.cfg]
2017-07-20 ADC送信できた
2017-07-20 ミスった
2017-07-20 基本的な機能(データの取得と送信)の完成
2017-07-20 非常停止スイッチの初期化
2017-07-21 コメントとデータ取得のバグ修正
2017-07-21 Enableの機能追加とRHC構造体から非常停止のメンバ削除
2017-07-25 基板側のADCポートの定義追加
    [rhand_controller.kicad_pcb]
2017-07-25 基板側のセンサの名前付けに対応
2017-07-28 STMstudioでデバッグするように色々追加
2017-07-29 ファイル構造の変更
2017-07-29 変更点がわかんないんだよなあ
2017-08-02 includeの仕方を変更
2017-08-07 ジョイスティック固定用の作成
    [ジョイスティック固定SLDPRT.SLDPRT]
2017-08-08 穴の配置はたぶん合ってる
    [ジョイスティック固定SLDPRT.SLDPRT]
2017-08-08 STLファイルをレポジトリに追加しないようにした
2017-08-08 基板固定用の穴と三端子レギュレータ回りの配線の変更
    [rhand_controller.kicad_pcb]
2017-08-09 ガーバー出力
    [rhand_controller.kicad_pcb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]
2017-08-09 ジョイスティックの作成
    [ジョイスティック.SLDPRT, ジョイスティックのカバー.SLDPRT]
2017-08-09 メイン基板の変更とジョイスティック固定用基板の作成
    [JoyStick.kicad_pcb, JoyStick.sch, rhand_controller.kicad_pcb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]
2017-08-22 ねじ穴付けた
    [ジョイスティックのカバー.SLDPRT]
2017-08-22 ジョイスティック固定威容の基板外形を円形へ変更
    [JoyStick.kicad_pcb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]
2017-08-22 固定用の穴追加
    [JoyStick.kicad_pcb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]
2017-08-22 数値確認用の従動寸法を追加
    [ジョイスティックのカバー.SLDPRT]
2017-08-23 持つところの設計
    [コントローラ(ジョイスティック).SLDASM, ジョイスティックのカバー.SLDPRT, ジョイスティック持つところ.SLDPRT, ジョイスティック持つところ_halfbody.SLDPRT, ジョイスティック持つところ_halfhead.SLDPRT]
2017-08-23 フォルダ構造の変更
    [Arms.sch, Digital_input.sch, Left_Hand.sch, Make_3.3V.sch, Right_hand.sch, RotarySW.sch, ST-LINK.sch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]
2017-08-24 Ver.2の設計開始
    [Arms.sch, Digital_input.sch, Left_Hand.sch, Make_3.3V.sch, Right_hand.sch, RotarySW.sch, ST-LINK.sch, rhand_controller.kicad_pcb]
2017-08-25 配置をちょっとした
    [rhand_controller.kicad_pcb]
2017-08-28 ラベル名のつけ方変更
    [rhand_controller.kicad_pcb, rhand_controller.sch]
2017-08-28 3Dプリンタで出力するための細かい変更
    [ジョイスティック持つところ_halfbody.SLDPRT, ジョイスティック持つところ_halfhead.SLDPRT]
2017-08-28 配線が半分完了,電源と無線モジュールが未配線
    [rhand_controller.kicad_pcb, rhand_controller.sch]
2017-08-29 コミット編集しようとしたら全部破棄されたからやる気失った
    [rhand_controller.kicad_pcb]
2017-09-01 回路設計完了
    [Left_Hand.sch, rhand_controller.kicad_pcb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]
2017-09-01 底面の追加
    [コントローラ(ジョイスティック).SLDASM, ジョイスティック持つところ_halfbody.SLDPRT, ジョイスティック持つところ_halfhead.SLDPRT]
2017-09-04 ケーブル径と結束バンド
    [コントローラ(ジョイスティック).SLDASM, ジョイスティック持つところ_halfbody.SLDPRT, ジョイスティック持つところ_halfhead.SLDPRT]
